jaketheduque/ESP32-Ambient-Lighting/README.md

Check out the project website here: https://jaketheduque.github.io/ESP32-Ambient-Lighting/
