jaketheduque/ESP32-Ambient-Lighting/docs/assets/Pasted image 20250603084900.png

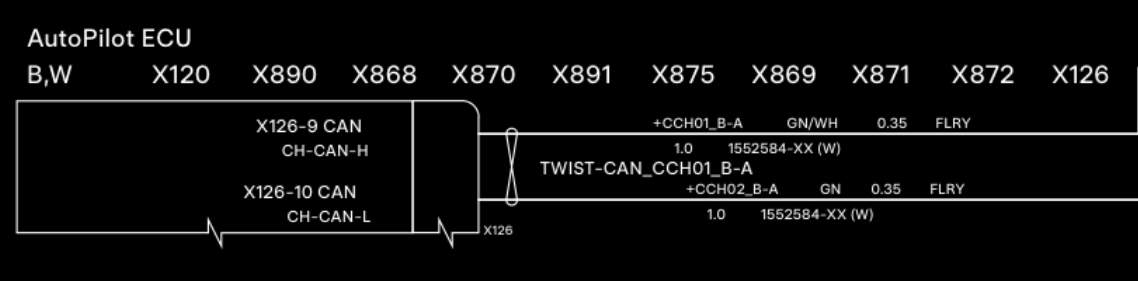
docs/assets/Pasted image 20250603084900.png
