jaketheduque/ESP32-Ambient-Lighting/docs/assets/Pasted image 20250603085106.png

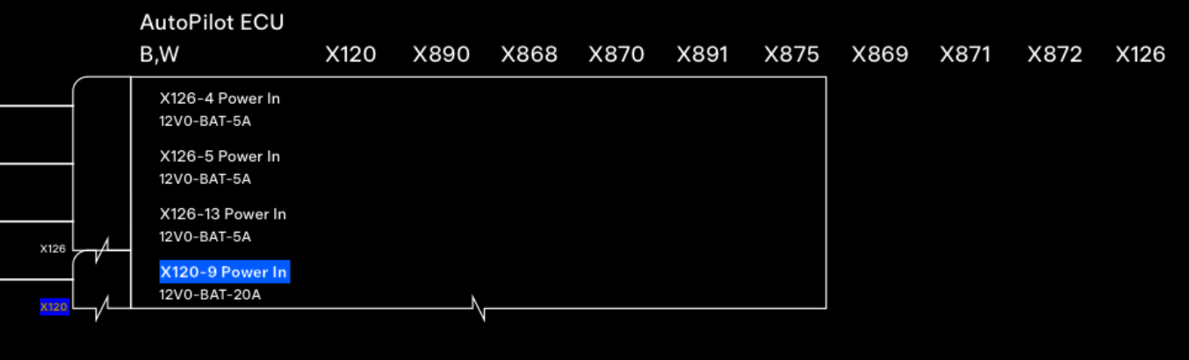
docs/assets/Pasted image 20250603085106.png
