jaketheduque/ESP32-Ambient-Lighting/docs/assets/Pasted image 20250603085405.png

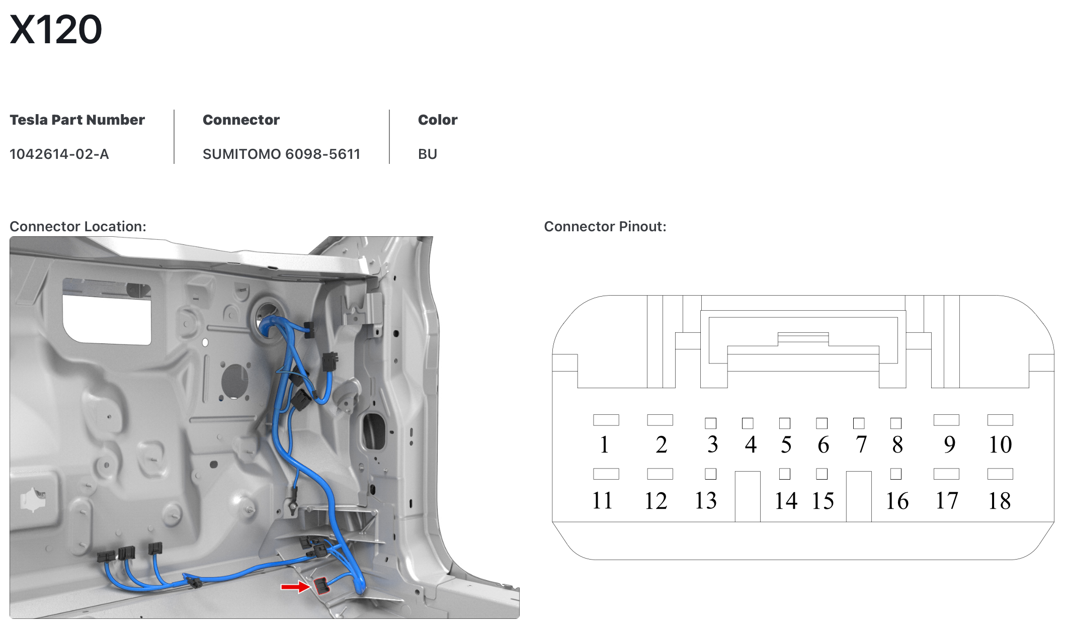
docs/assets/Pasted image 20250603085405.png
