jaketheduque/ESP32-Ambient-Lighting/docs/assets/Pasted image 20250603120248.png

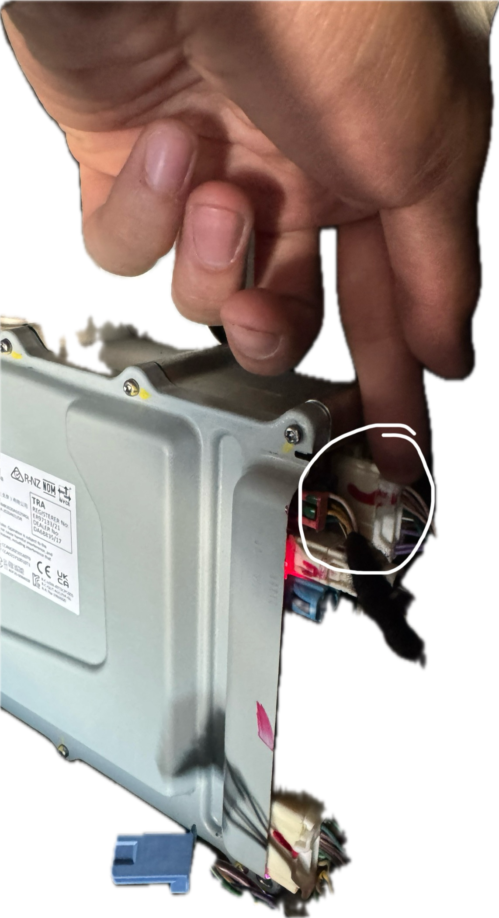
docs/assets/Pasted image 20250603120248.png
