jaketheduque/ESP32-Ambient-Lighting/docs/assets/Pasted image 20250603120410.jpg

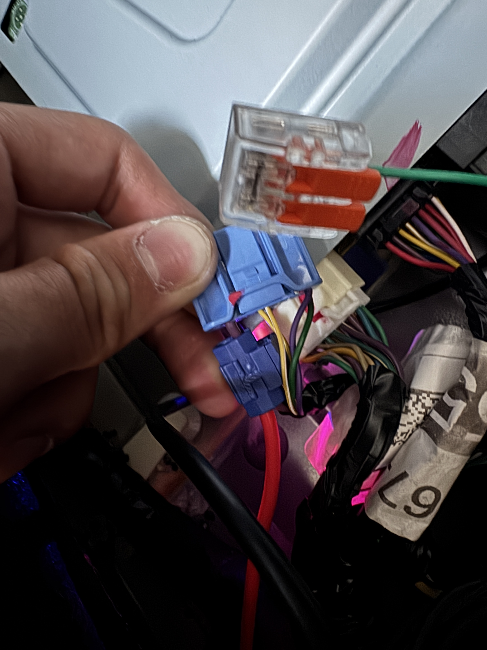
docs/assets/Pasted image 20250603120410.jpg
