jaketheduque/ESP32-Ambient-Lighting/docs/assets/Tesla Ambient Lighting-1747267039862.png

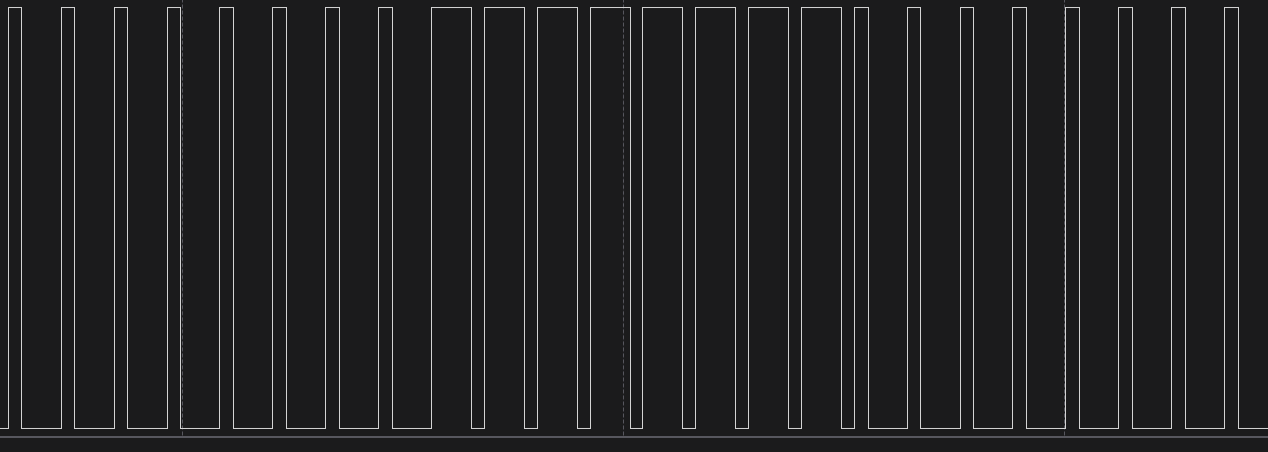
docs/assets/Tesla Ambient Lighting-1747267039862.png
