jaketheduque/ESP32-Ambient-Lighting/docs/assets/Tesla Ambient Lighting-1747267092819.png

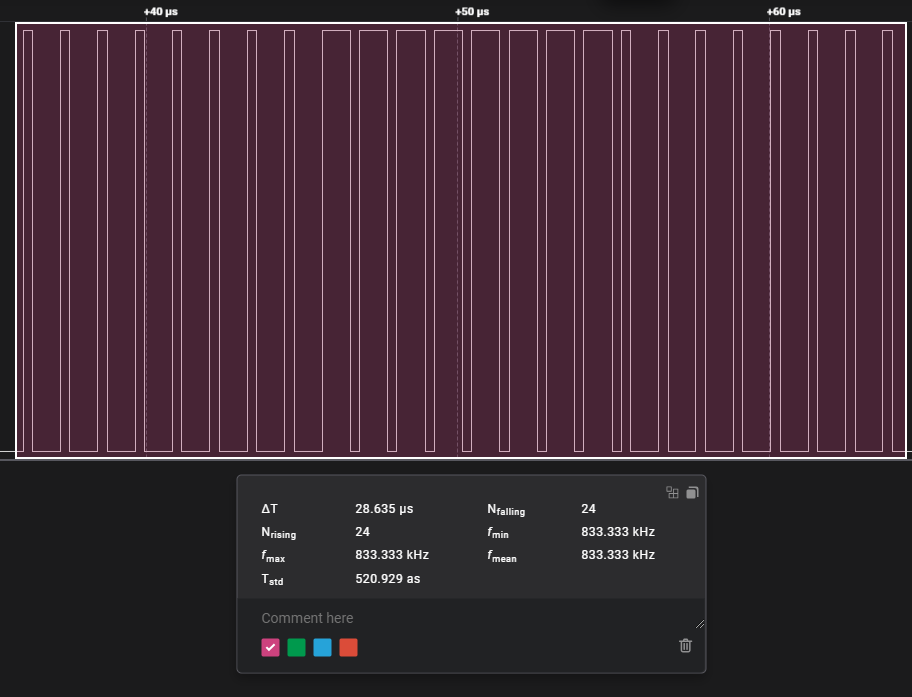
docs/assets/Tesla Ambient Lighting-1747267092819.png
