jaketheduque/ESP32-Ambient-Lighting/docs/assets/Tesla Ambient Lighting-1747267523833.png

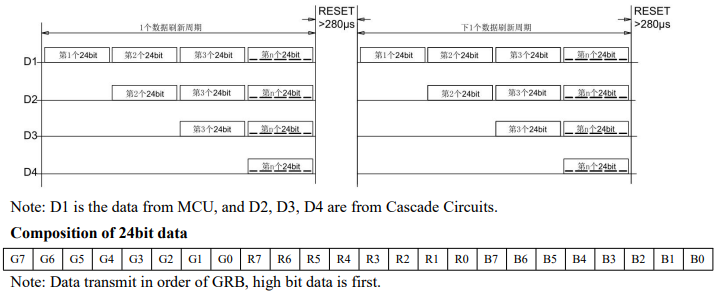
docs/assets/Tesla Ambient Lighting-1747267523833.png
