jaketheduque/ESP32-Ambient-Lighting/docs/assets/Tesla Ambient Lighting-1747695016590.png

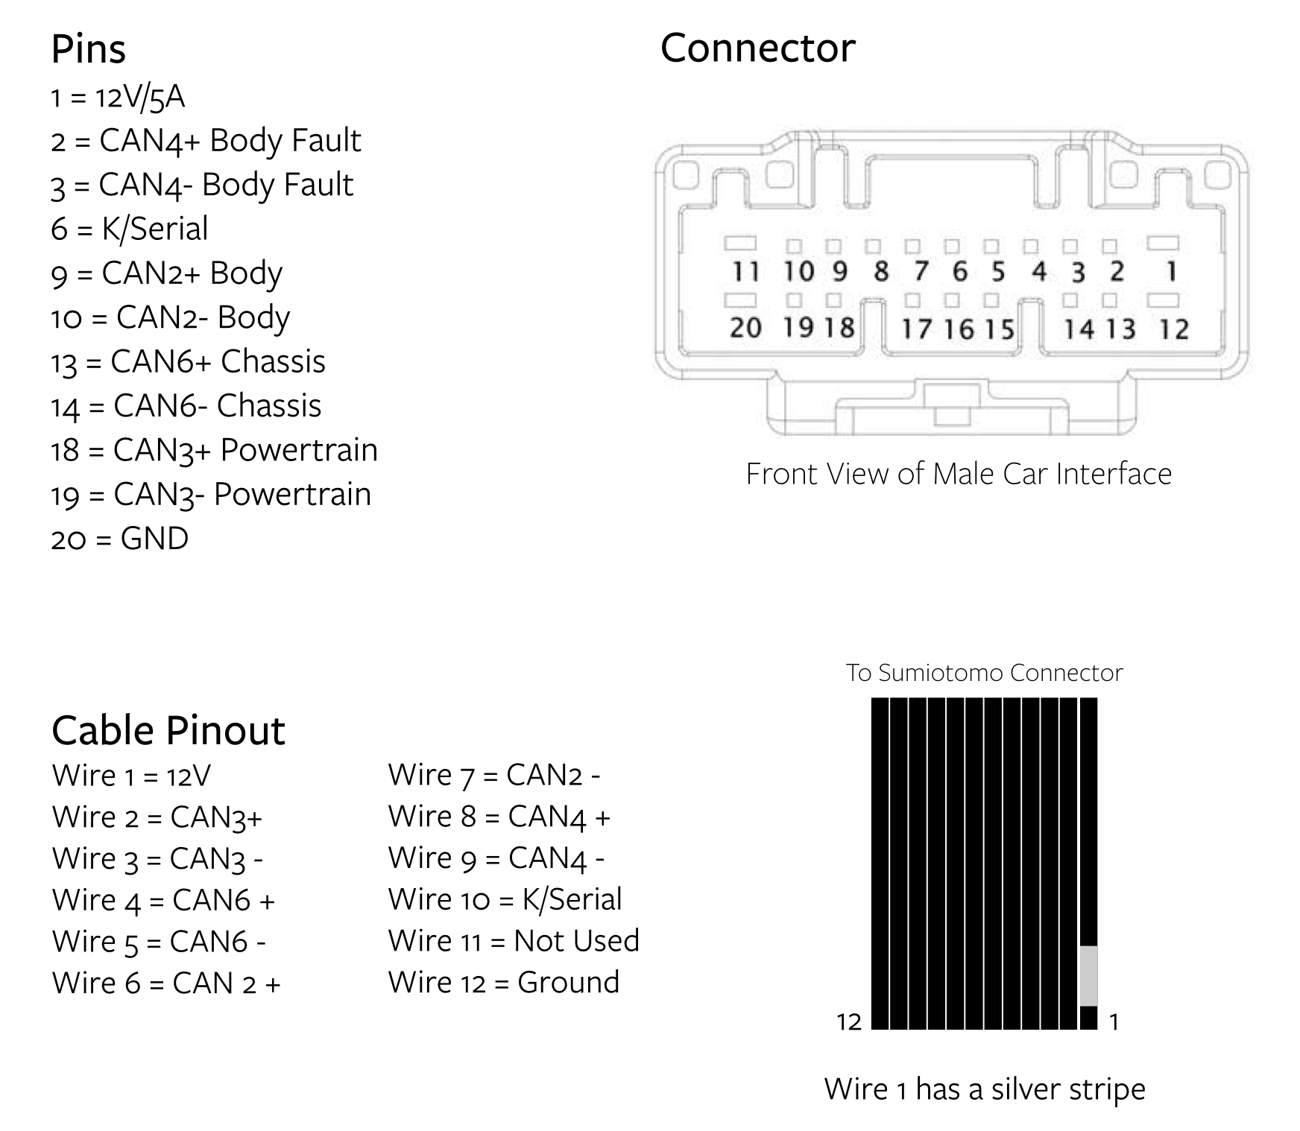
docs/assets/Tesla Ambient Lighting-1747695016590.png
