jaketheduque/ESP32-Ambient-Lighting/docs/assets/Tesla Ambient Lighting-1750134048209.jpg

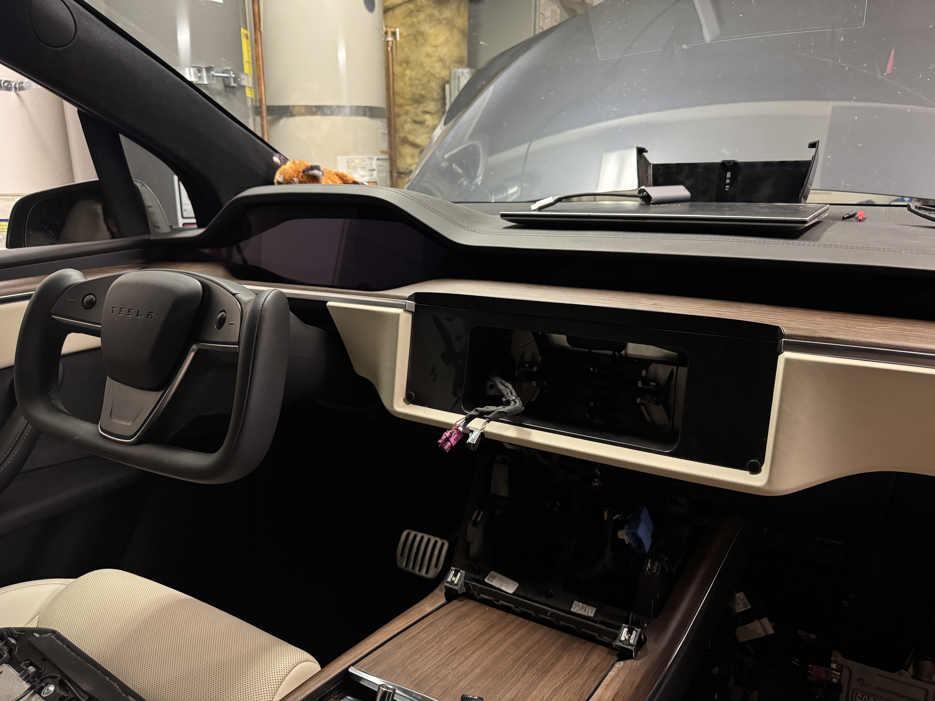
docs/assets/Tesla Ambient Lighting-1750134048209.jpg
