jaketheduque/ESP32-Ambient-Lighting/docs/assets/Tesla Ambient Lighting-1750134827998.jpg

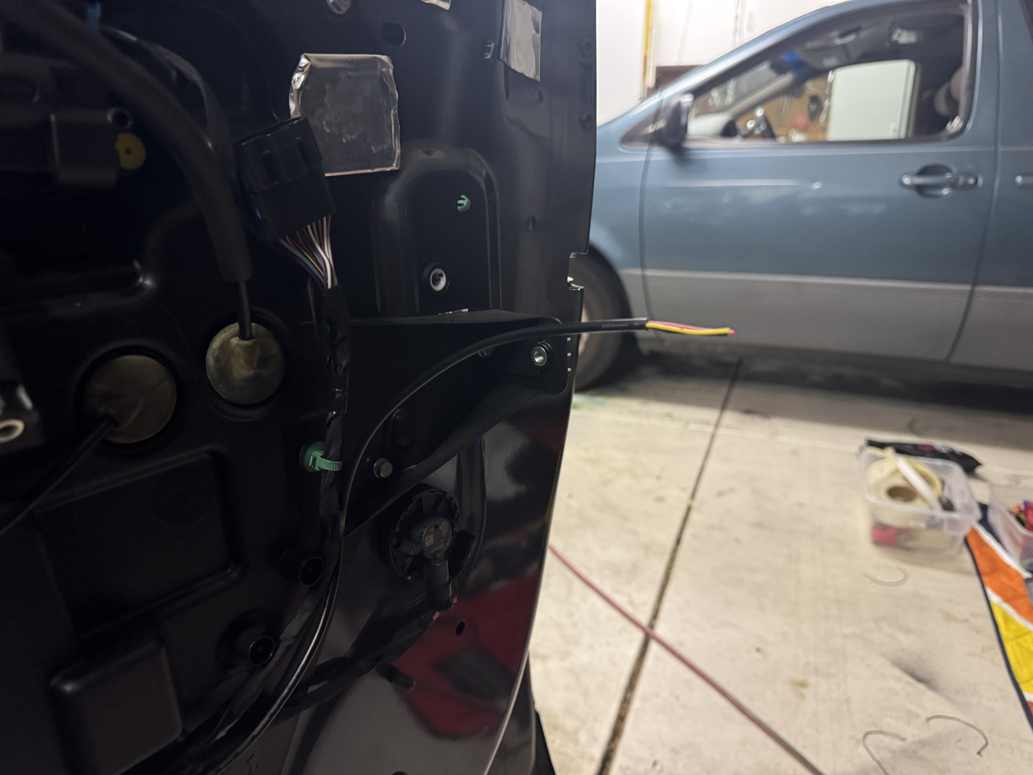
docs/assets/Tesla Ambient Lighting-1750134827998.jpg
