jaketheduque/ESP32-Ambient-Lighting/docs/assets/Tesla Ambient Lighting-1750134945630.jpg

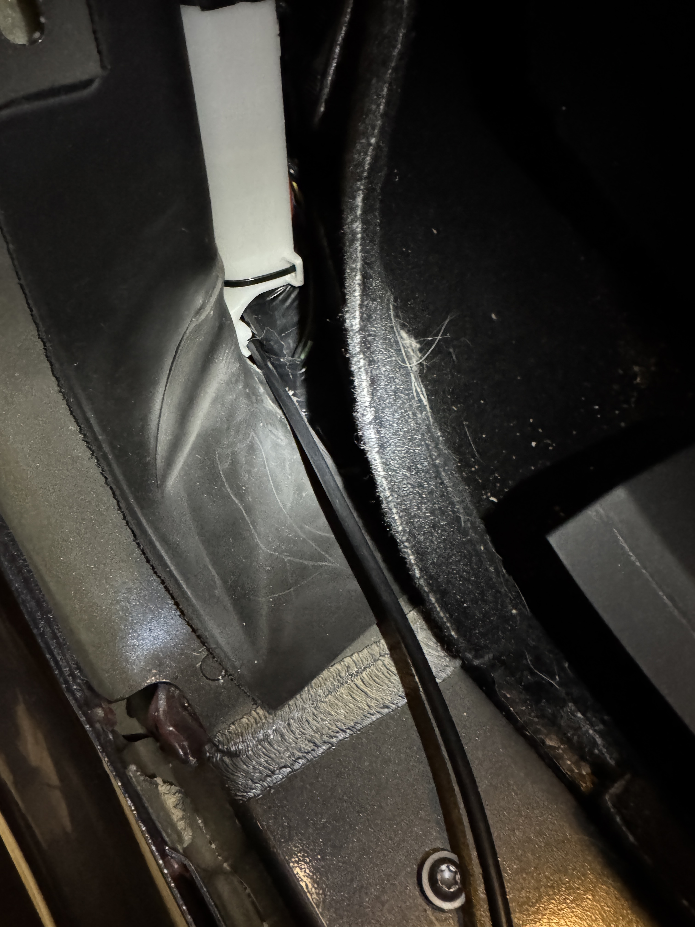
docs/assets/Tesla Ambient Lighting-1750134945630.jpg
