jaketheduque/ESP32-Ambient-Lighting/docs/assets/Tesla Ambient Lighting-1750135095715.jpg

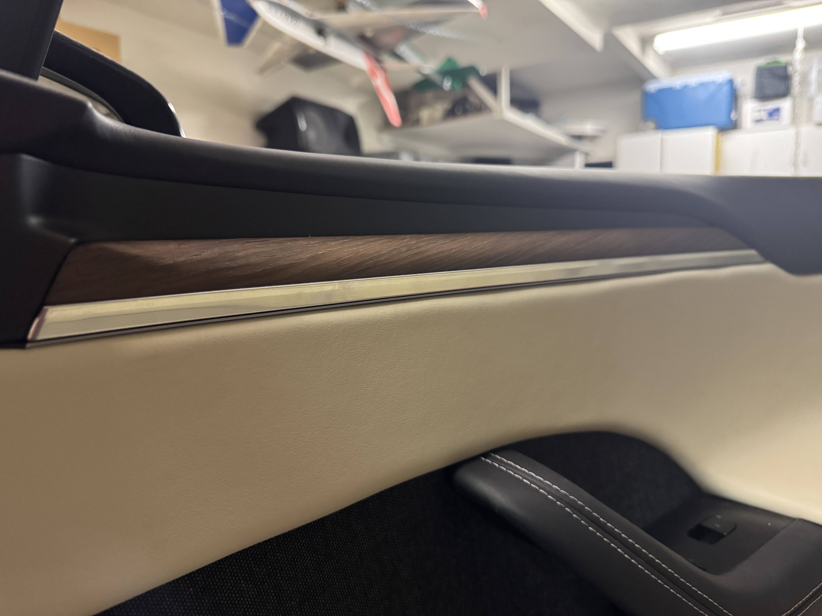
docs/assets/Tesla Ambient Lighting-1750135095715.jpg
