jaketheduque/ESP32-Ambient-Lighting/docs/assets/Tesla Ambient Lighting-1751386897733.png

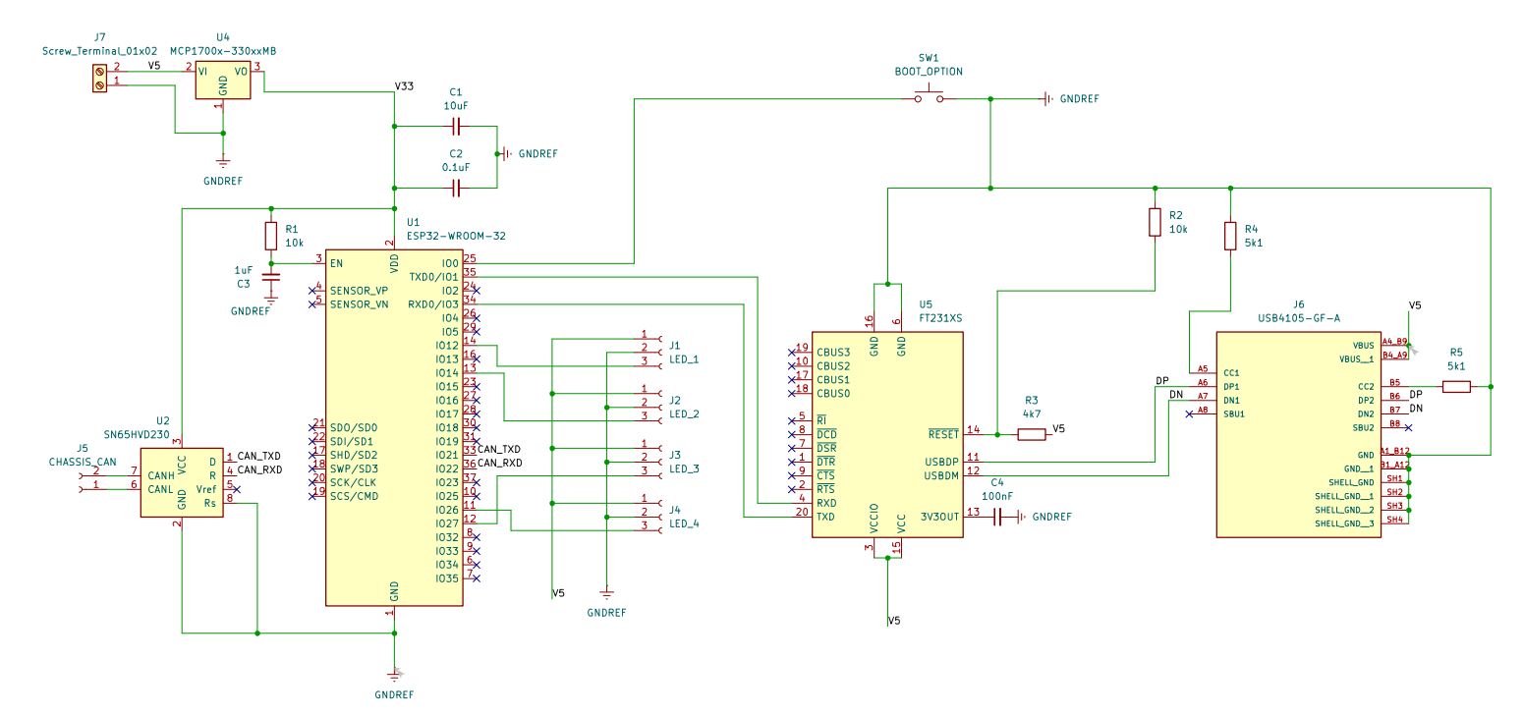
docs/assets/Tesla Ambient Lighting-1751386897733.png
