jaketheduque/ESP32-Ambient-Lighting/docs/assets/Tesla Ambient Lighting-1751386955666.png

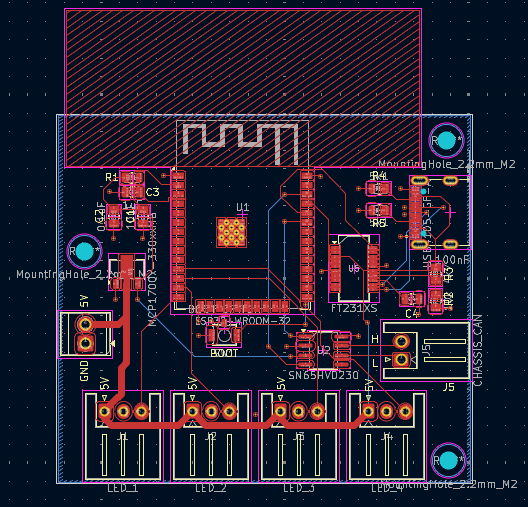
docs/assets/Tesla Ambient Lighting-1751386955666.png
