jaketheduque/ESP32-Ambient-Lighting/docs/assets/Tesla Ambient Lighting-1752691864625.jpg

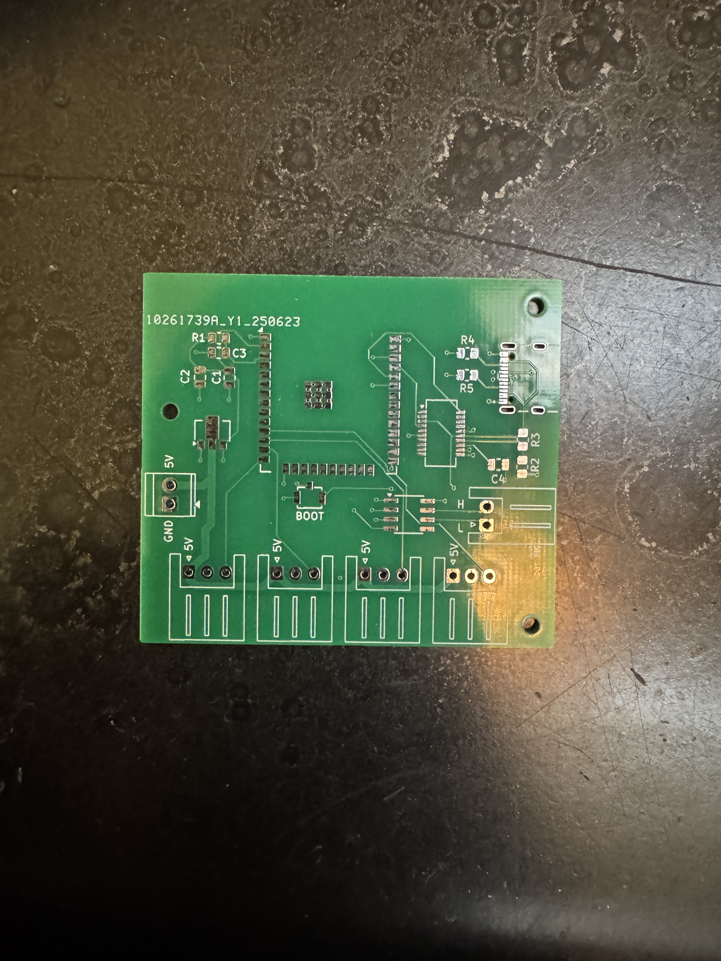
docs/assets/Tesla Ambient Lighting-1752691864625.jpg
