jaketheduque/ESP32-Ambient-Lighting/docs/assets/Tesla Ambient Lighting-1752692404711.jpg

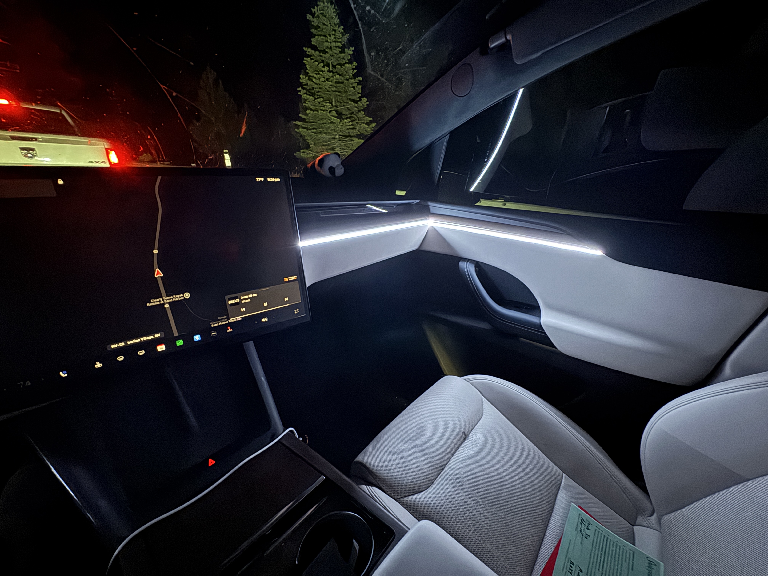
docs/assets/Tesla Ambient Lighting-1752692404711.jpg
