jaketheduque/ESP32-Ambient-Lighting/pcb/Tesla Ambient Lighting.step

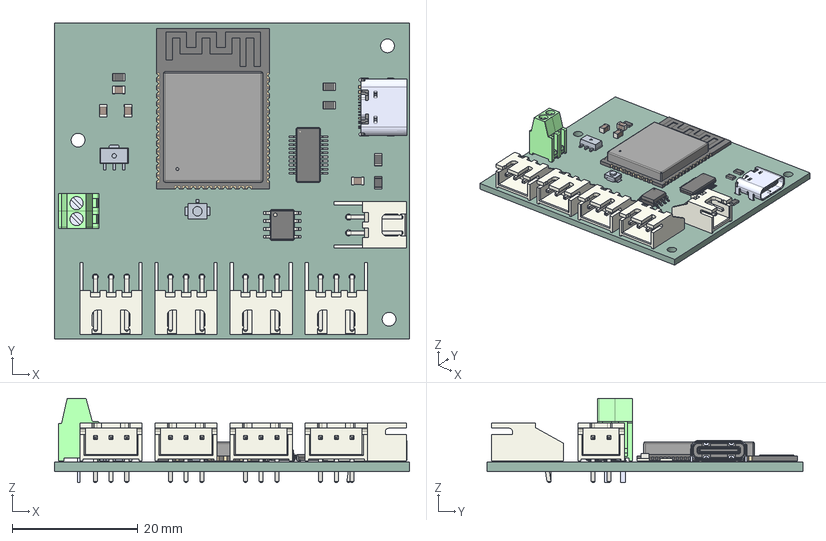
[picture p36: CAD file, 2026-01-12]
pcb/Tesla Ambient Lighting.step
56.5 x 50.2 x 13.4 mm
JST_XH_S2B-XH-A_1x02_P2.50mm_Horizontal
Tesla Ambient Lighting 1.2.1
USB4105GFA_USB4105GFA
SSOP-20_3.9x8.7mm_P0.635mm
C_0805_2012Metric x 4
R_0805_2012Metric x 5
SW_SPST_B3U-1100P
JST_XH_S3B-XH-A_1x03_P2.50mm_Horizontal x 4
TerminalBlock_TE_282834-2_1x02_P2.54mm_Horizontal
ESP32-WROOM-32E
SOIC-8_3.9x4.9mm_P1.27mm
Tesla Ambient Lighting_PCB
