jaketheduque/ESP32-Ambient-Lighting/pcb/schematic.pdf

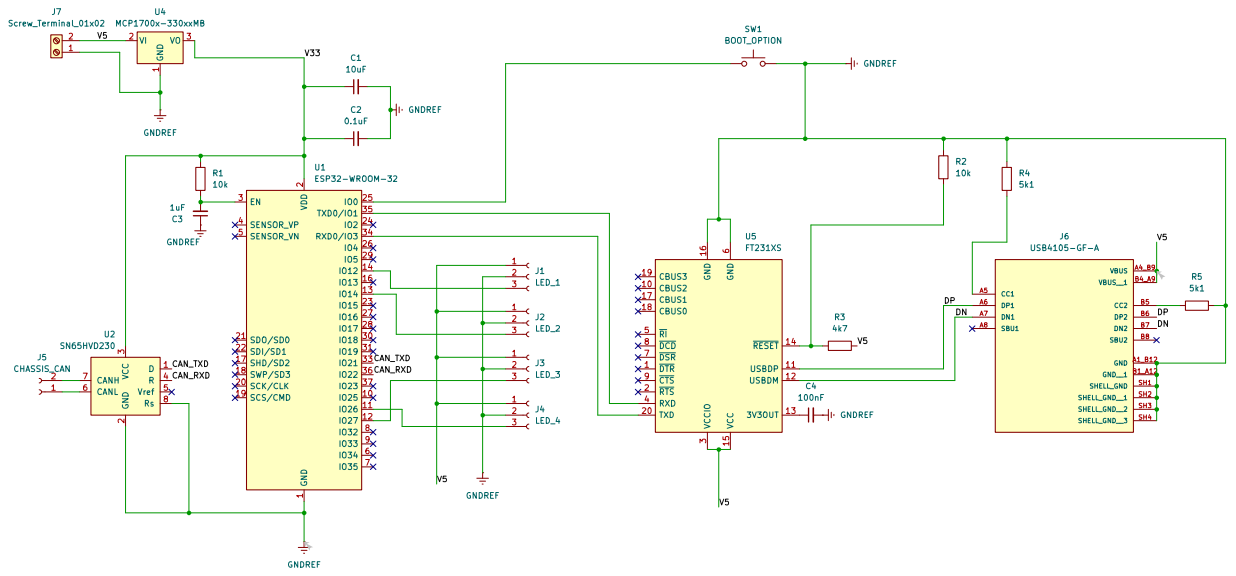
[picture p37: page 1]
