jaketheduque/ESP32-Ambient-Lighting/pcb/Tesla Ambient Lighting.kicad_pcb

## KiCad design pcb/Tesla Ambient Lighting.kicad_pcb (2026-01-19)

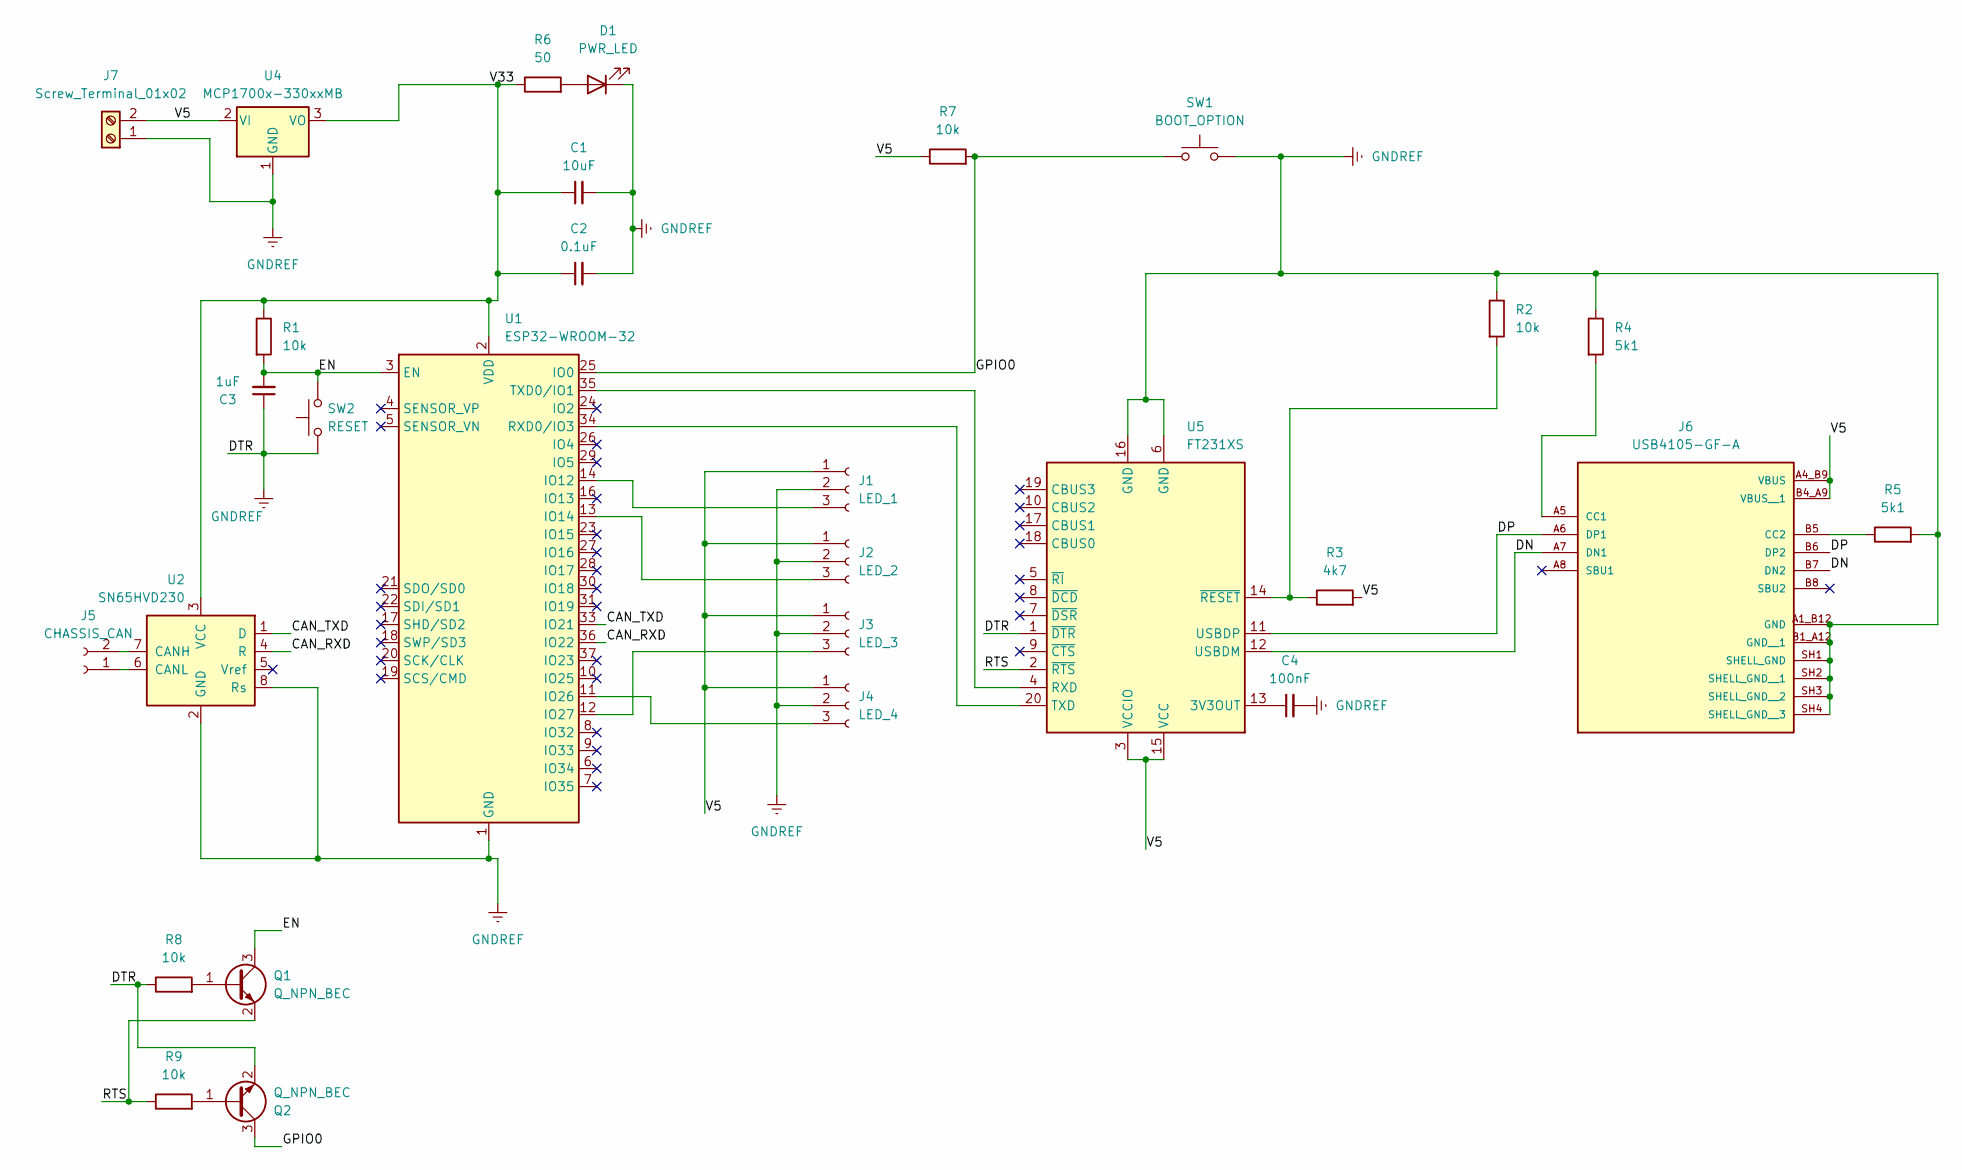
[picture p38: schematic Tesla Ambient Lighting.kicad_sch]

Parts:
C1: 10uF; C_0805_2012Metric
C2: 0.1uF; C_0805_2012Metric
C3: 1uF; C_0805_2012Metric
C4: 100nF; C_0805_2012Metric
D1: PWR_LED; LED_0805_2012Metric
J1: LED_1; JST_XH_S3B-XH-A_1x03_P2.50mm_Horizontal
J2: LED_2; JST_XH_S3B-XH-A_1x03_P2.50mm_Horizontal
J3: LED_3; JST_XH_S3B-XH-A_1x03_P2.50mm_Horizontal
J4: LED_4; JST_XH_S3B-XH-A_1x03_P2.50mm_Horizontal
J5: CHASSIS_CAN; JST_XH_S2B-XH-A_1x02_P2.50mm_Horizontal
J6: USB4105-GF-A; GCT_USB4105-GF-A; PARTREV B4
J7: Screw_Terminal_01x02; TerminalBlock_TE_282834-2_1x02_P2.54mm_Horizontal
Q1, Q2: Q_NPN_BEC; SOT-23
R1, R2, R7, R8, R9: 10k; R_0805_2012Metric
R3: 4k7; R_0805_2012Metric
R4, R5: 5k1; R_0805_2012Metric
R6: 50; R_0805_2012Metric
SW1: BOOT_OPTION; SW_SPST_B3U-1100P
SW2: RESET; SW_SPST_B3U-1100P
U1: ESP32-WROOM-32; ESP32-WROOM-32E
U2: SN65HVD230; SOIC-8_3.9x4.9mm_P1.27mm
U4: MCP1700x-330xxMB; SOT-89-3
U5: FT231XS; SSOP-20_3.9x8.7mm_P0.635mm

Connections:
/CAN_RXD: U1.36 (IO22), U2.4 (R)
/CAN_TXD: U1.33 (IO21), U2.1 (D)
/DN: J6.A7 (DN1), J6.B7 (DN2), U5.12 (USBDM)
/DP: J6.A6 (DP1), J6.B6 (DP2), U5.11 (USBDP)
/EN: C3.2, Q1.3 (C), R1.2, SW2.2, U1.3 (EN); also elsewhere on the board
/GPIO0: Q2.3 (C), R7.2, SW1.1, U1.25 (IO0)
/RTS: Q1.2 (E), R9.1, U5.2 (~RTS)
/V5: J1.1, J2.1, J3.1, J4.1, J6.A4_B9 (VBUS), J6.B4_A9 (VBUS__1), J7.2, R3.2, R7.1, U4.2 (VI), U5.3 (VCCIO), U5.15 (VCC)
/V33: C1.1, C2.1, R1.1, R6.1, U1.2 (VDD), U2.3 (VCC), U4.3 (VO)
GNDREF: C1.2, C2.2, C3.1, C4.2, D1.1 (K), J1.2, J2.2, J3.2, J4.2, J6.A1_B12 (GND), J6.B1_A12 (GND__1), J6.SH1 (SHELL_GND), J6.SH2 (SHELL_GND__1), J6.SH3 (SHELL_GND__2), J6.SH4 (SHELL_GND__3), J7.1, Q2.2 (E), R2.1, R4.1, R5.2, R8.1, SW1.2, SW1.3, SW2.1, U1.1 (GND), U1.15 (GND), U1.38 (GND), U1.39 (GND), U2.2 (GND), U2.8 (Rs), U4.1 (GND), U5.1 (~DTR), U5.6 (GND), U5.16 (GND); also elsewhere on the board
unnamed 10: D1.2 (A), R6.2; also elsewhere on the board
unnamed: J1.3, U1.14 (IO12)
unnamed: J2.3, U1.13 (IO14)
unnamed: J3.3, U1.12 (IO27)
unnamed: J4.3, U1.11 (IO26)
unnamed: J5.1, U2.6 (CANL)
unnamed: J5.2, U2.7 (CANH)
unnamed: J6.A5 (CC1), R4.2
unnamed: J6.B5 (CC2), R5.1
unnamed: Q1.1 (B), R8.2
unnamed: Q2.1 (B), R9.2
unnamed: U1.34 (RXD0/IO3), U5.20 (TXD)
unnamed: U1.35 (TXD0/IO1), U5.4 (RXD)
unnamed: C4.1, U5.13 (3V3OUT)
unnamed: R2.2, R3.1, U5.14 (~RESET)

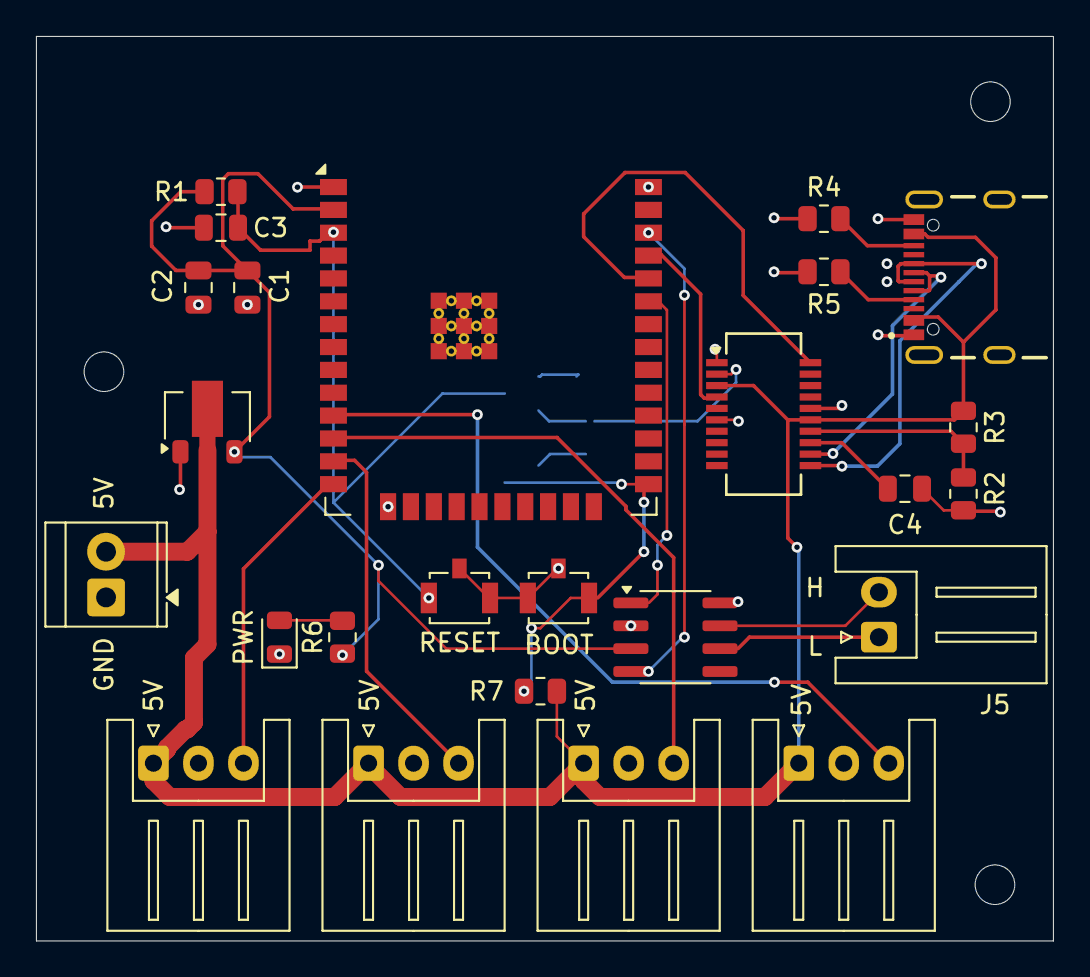
[picture p39: board Tesla Ambient Lighting.kicad_pcb from above]

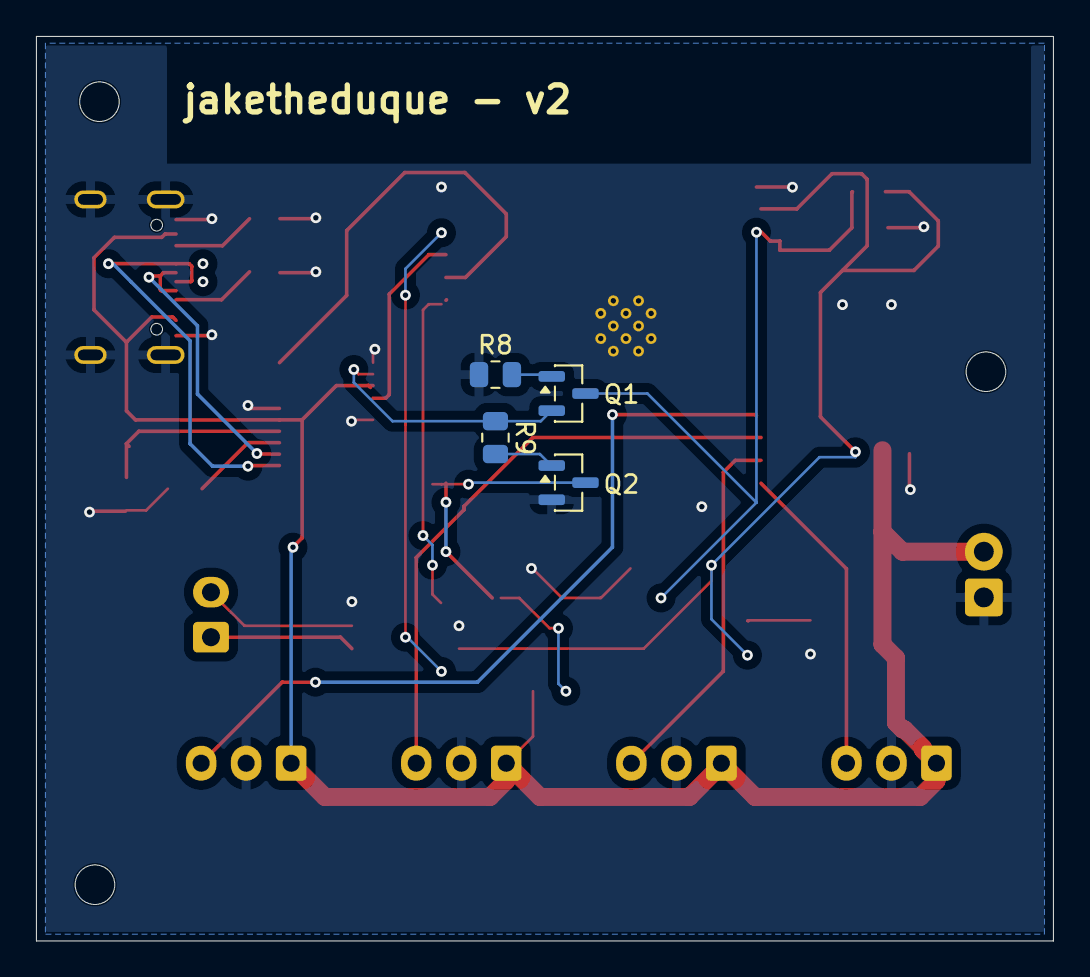
[picture p40: board Tesla Ambient Lighting.kicad_pcb from below]

Board: 2 copper layers, 56.5 x 50.2 mm, 29 parts (4 on the bottom side), 25 nets.

Other parts of the board:
PWR: PWR_LED; LED_0805_2012Metric
RESET: RESET; SW_SPST_B3U-1100P

Their connections:
/EN: RESET.2; also elsewhere on the board
GNDREF: PWR.1 (K), RESET.1, RESET.3; also elsewhere on the board
unnamed 10: PWR.2 (A); also elsewhere on the board
