jaketheduque/ESP32-Ambient-Lighting/main/main_common.h

#ifndef MAIN_COMMON_H
#define MAIN_COMMON_H

#include "freertos/FreeRTOS.h"
#include "freertos/task.h"
#include "driver/gpio.h"
#include "freertos/queue.h"
#include "freertos/semphr.h"
#include "esp_check.h"
#include "esp_log.h"
#include "sdkconfig.h"

#include <stdio.h>
#include <string.h>
#include <led_strip.h>
#include <stdint.h>
#include <stdbool.h>

/* =========================
 *        ENUMERATIONS
 * ========================= */
typedef enum {
  COMMAND_SET_COLOR,
  COMMAND_SEQUENTIAL,
  COMMAND_FADE_TO,
} CommandType;

typedef enum {
  LIGHT_ON,
  LIGHT_TRANSITIONING,
  LIGHT_OFF,
} LightState;

/* =========================
 *         STRUCTS
 * ========================= */
typedef struct {
  uint8_t red;
  uint8_t green;
  uint8_t blue;
} rgb_t;

typedef struct {
  uint8_t num_steps;
  uint32_t delay_ms;
  bool reverse;
} sequential_step_t;

typedef struct command_t {
  CommandType type;
  struct {
    rgb_t color;
    sequential_step_t step;
  } data;
  QueueHandle_t chained_command_queue;
  struct command_t* chained_command;
} command_t;

typedef struct {
  led_strip_config_t strip_config;
  led_strip_rmt_config_t rmt_config;
  QueueHandle_t command_queue;
  LightState state;
  rgb_t current_led_color;
} ambient_light_t;

/* =========================
 *        GENERAL MACROS
 * ========================= */
#define NUM_LIGHTS 2

#define DASHBOARD_INDEX 0
#define DOOR_INDEX 1

#define DEFAULT_FADE_STEPS 20
#define DEFAULT_FADE_DELAY_MS 20
#define DEFAULT_SEQUENTIAL_STEPS 2
#define DEFAULT_SEQUENTIAL_DELAY_MS 20

#define START_COLOR (rgb_t) {100, 100, 100}
#define COLOR_OFF (rgb_t) {0, 0, 0}

#define DISPLAY_CAN_ID 0x3B3
#define DISPLAY_STATUS_BYTE_INDEX 2
#define DISPLAY_POWER_MASK 0x04
#define DISPLAY_STANDARD_UI_MASK 0x04

#define LIGHTS_CAN_ID 0x3F5
#define TS_BYTE_INDEX 0
#define LEFT_TS_MASK 0x02
#define RIGHT_TS_MASK 0x08
#define AMBIENT_LIGHT_BYTE_INDEX 1

/* Hardware filter: accept only 0x3B3 (DISPLAY_CAN_ID) and 0x3F5 (LIGHTS_CAN_ID).
 * XOR of the two IDs gives the bits that differ (0x046). The acceptance code holds
 * the common bits of both IDs, and the mask marks differing ID bits + all non-ID
 * bits as "don't care" (1 = don't care in ESP32 TWAI filter). */
#define TWAI_FILTER_ID_XOR   (DISPLAY_CAN_ID ^ LIGHTS_CAN_ID)
#define TWAI_ACCEPTANCE_CODE ((uint32_t)(DISPLAY_CAN_ID & ~TWAI_FILTER_ID_XOR) << 21)
#define TWAI_ACCEPTANCE_MASK (((uint32_t)TWAI_FILTER_ID_XOR << 21) | 0x001FFFFF)

#define LIGHT_CONTROLLER_TASK_PRIORITY 5
#define WEB_SERVER_TASK_PRIORITY 10

#define RISING_CHANGE(current, previous, bit_mask) (((current) & (bit_mask)) && !((previous) & (bit_mask)))
#define FALLING_CHANGE(current, previous, bit_mask) (!((current) & (bit_mask)) && ((previous) & (bit_mask)))

/* =========================================================
 *                  SHARED GLOBAL MEMBERS
 * ========================================================= */
extern ambient_light_t lights[NUM_LIGHTS];
extern SemaphoreHandle_t current_color_lock;
/**
 * @note Access to current_color must be protected by taking the appropriate semaphore
 *       before entering the critical section to ensure thread safety.
 */
extern rgb_t current_color;

/* =========================================================
 *                      FUNCTIONS
 * ========================================================= */
esp_err_t start_can_sniffer_task();
esp_err_t start_http_server_task();
esp_err_t init_ambient_light(ambient_light_t *light, const int gpio_num, const int max_leds);

#endif // MAIN_COMMON_H
