jaketheduque/ESP32-Ambient-Lighting/(commit log)

2025-06-02 wrote untested code for CAN bus light control
2025-06-08 current color shared globally
2025-06-17 fixed semaphore initialization so that it is not blocking tasks
    [main.c, main_common.h]
2025-08-06 fixed display CAN mask
    [can_bus_sniffer.c, main_common.h]
2025-08-06 removed current_color from ambient_light_t and updated commands
2025-08-11 fixed light control logic
    [can_bus_sniffer.c, lights_controller.c]
2025-08-14 fixed control logic to correctly set light state to OFF; added script for sending OTA update
    [can_bus_sniffer.c, http_server.c, lights_controller.c, main_common.h]
2026-01-12 added PCB files
    [Tesla Ambient Lighting-B_Cu.gbr, Tesla Ambient Lighting-B_Mask.gbr, Tesla Ambient Lighting-B_Paste.gbr, Tesla Ambient Lighting-B_Silkscreen.gbr, Tesla Ambient Lighting-Edge_Cuts.gbr, Tesla Ambient Lighting-F_Cu.gbr, Tesla Ambient Lighting-F_Mask.gbr, Tesla Ambient Lighting-F_Paste.gbr]
2026-01-16 started PCB V2; adding DTR and RTS control pins, RST button, and power LED; also wanting to add serial LED
    [Tesla Ambient Lighting.kicad_pcb, Tesla Ambient Lighting.kicad_sch]
2026-01-19 updated pcb to have RST button, power LED, and flow control
    [BOM.csv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]
2026-01-19 generate jlcpcb plots
    [BOM.csv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]
2026-03-03 fixed fade to command
    [lights_controller.c, main_common.h]
