jaketheduque/ESP32-Ambient-Lighting/docs/assets/Tesla Ambient Lighting-1752692150080.jpg

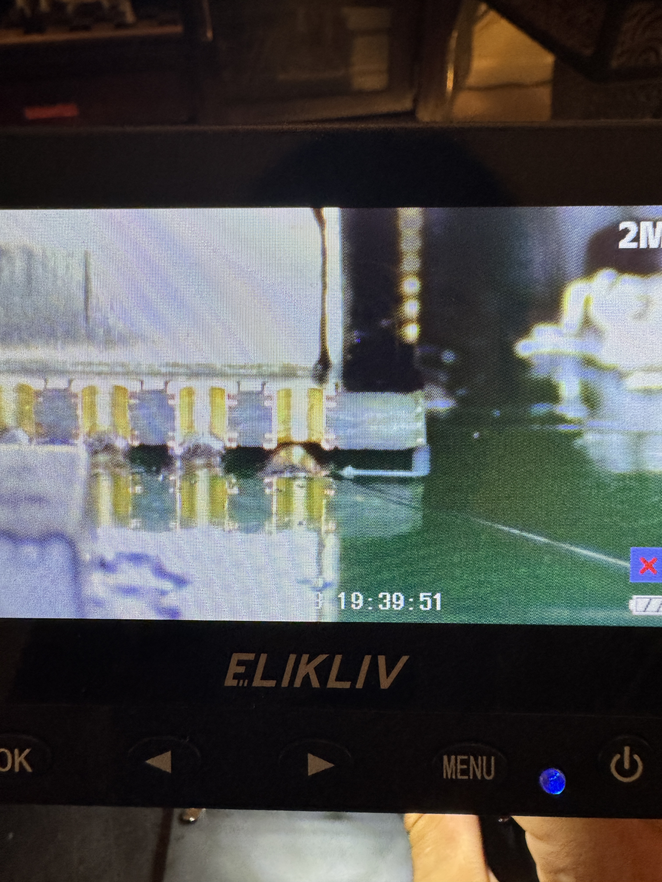
docs/assets/Tesla Ambient Lighting-1752692150080.jpg
